sylphase/gpslog/notes.txt

solder paste stencil needs wider openings on NV08C-CSM to reach pad
remember to solder through-holes on USB connector
next revision should have a way to charge the battery via USB
