sylphase/gpslog/orders/newark1.pdf

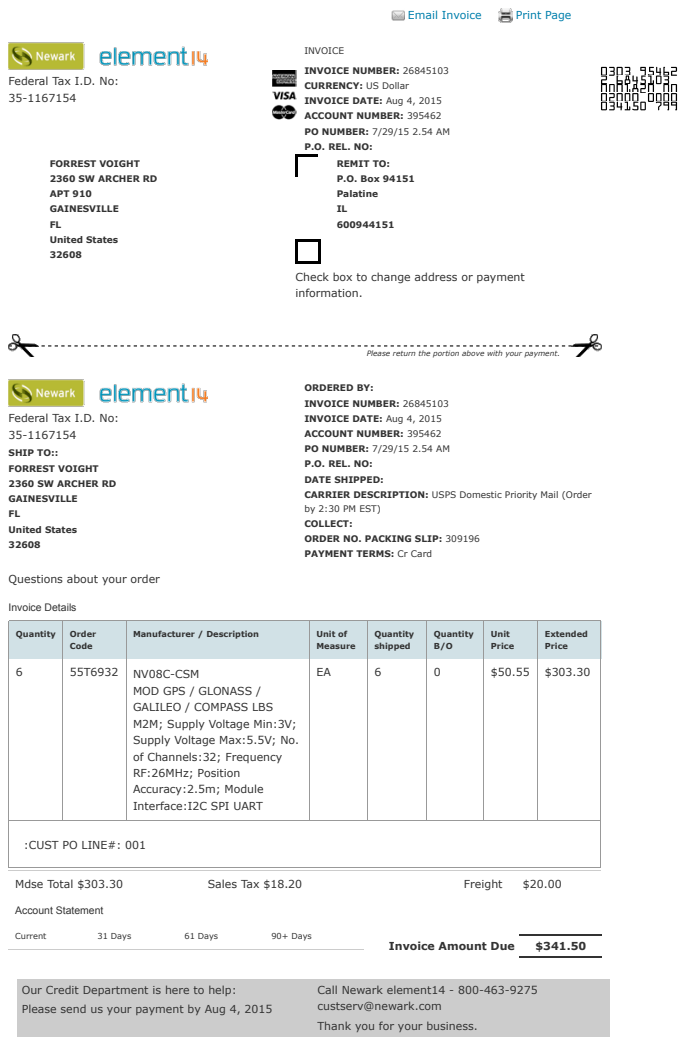
[picture p1: figure]
Email Invoice; Print Page; Federal Tax I.D. No: 35-1167154; INVOICE; INVOICE NUMBER: 26845103 CURRENCY: US Dollar INVOICE DATE: Aug 4, 2015 ACCOUNT NUMBER: 395462 PO NUMBER: 7/29/15 2.54 AM P.O. REL. NO:; FORREST VOIGHT 2360 SW ARCHER RD APT 910 GAINESVILLE FL United States 32608; SHIP TO:: FORREST VOIGHT 2360 SW ARCHER RD GAINESVILLE FL United States 32608; ORDERED BY: INVOICE NUMBER: 26845103 INVOICE DATE: Aug 4, 2015 ACCOUNT NUMBER: 395462 PO NUMBER: 7/29/15 2.54 AM P.O. REL. NO: DATE SHIPPED:; by 2:30 PM EST) COLLECT: ORDER NO. PACKING SLIP: 309196 PAYMENT TERMS: Cr Card; Current; 31 Days; 61 Days; 90+ Days; Invoice Amount Due; Our Credit Department is here to help:; Call Newark element14 - 800-463-9275 custserv@newark.com Thank you for your business.; Questions about your order; Invoice Details; Quantity; Order; Code; Manufacturer / Description; Unit of; Measure; Quantity shipped; Quantity B/O; Unit Price; Extended Price; NV08C-CSM; MOD GPS / GLONASS / GALILEO / COMPASS LBS M2M; Supply Voltage Min:3V; Supply Voltage Max:5.5V; No. of Channels:32; Frequency RF:26MHz; Position Accuracy:2.5m; Module Interface:I2C SPI UART; :CUST PO LINE#: 001; Mdse Total $303.30; Sales Tax $18.20; Freight; Account Statement; REMIT TO: P.O. Box 94151 Palatine IL 600944151; Check box to change address or payment information.

CARRIER DESCRIPTION: USPS Domestic Priority Mail (Order

Please send us your payment by Aug 4, 2015

Please return the portion above with your payment.

Newark element14 | https://www.newark.com/webapp/wcs/stores/servlet...
1 of 2 | 08/20/2015 07:26 PM

Newark element14 | https://www.newark.com/webapp/wcs/stores/servlet...
2 of 2 | 08/20/2015 07:26 PM
