sylphase/gpslog/orders/2a/oshpark1.pdf

Forrest Voight.
Home Shared Projects Design Rules Pricing & Specs Support Projects Order History Profile Cart Log out

# OSH Park

## Order Details

Order
number 5rKx9BIw

Order status Payment verification has been received from Stripe. Ordered on September 24th 2015.
Paid on September 24th 2015 via Stripe.

Items

gpslog_imu

0.38x0.42 inch (9.70x10.59 mm) 2 layer board. Your boards have been received from the fab and are awaiting depanelization and shipping.

12 boards at $0.75 per batch of three. | $3.00
OSH Park ~ Order Details | 10/06/2015 02:26 AM
https://oshpark.com/orders/5rKx9BIw | 1 of 2

Sub total | $3.00

gpslog_2a

1.45x1.12 inch (36.80x28.40 mm) 4 layer board. Your boards have been shipped. Track here.

3 boards at $16.10 per batch of three. | $16.10
Sub total | $16.10
USPS - Priority Mail | $5.00
TOTAL (paid) | $24.10

Shipping
Address

Forrest Voight
Sylphase
2360 SW Archer Rd
Apt 910
Gainesville
32608
Florida
United States

Designed and developed by Resistor.

OSH Park ~ Order Details | 10/06/2015 02:26 AM
https://oshpark.com/orders/5rKx9BIw | 2 of 2
