sylphase/gpslog/orders/navspark1.pdf

My Account | Sign out | Items / $0.00
NavSpark Store | Search
Home | My Account | Add New Address

# MY ACCOUNT

DEVELOPMENT BOARDS ADDITIONAL MODULES ACCESSORIES FREEBIE FORUM RESOURCES ABOUT CONTACT US TERMS

All prices are in USD

NavSpark Store - Order #1302 | https://store-lgdi92x.mybigcommerce.com/account.p...
1 of 3 | 08/20/2015 07:23 PM

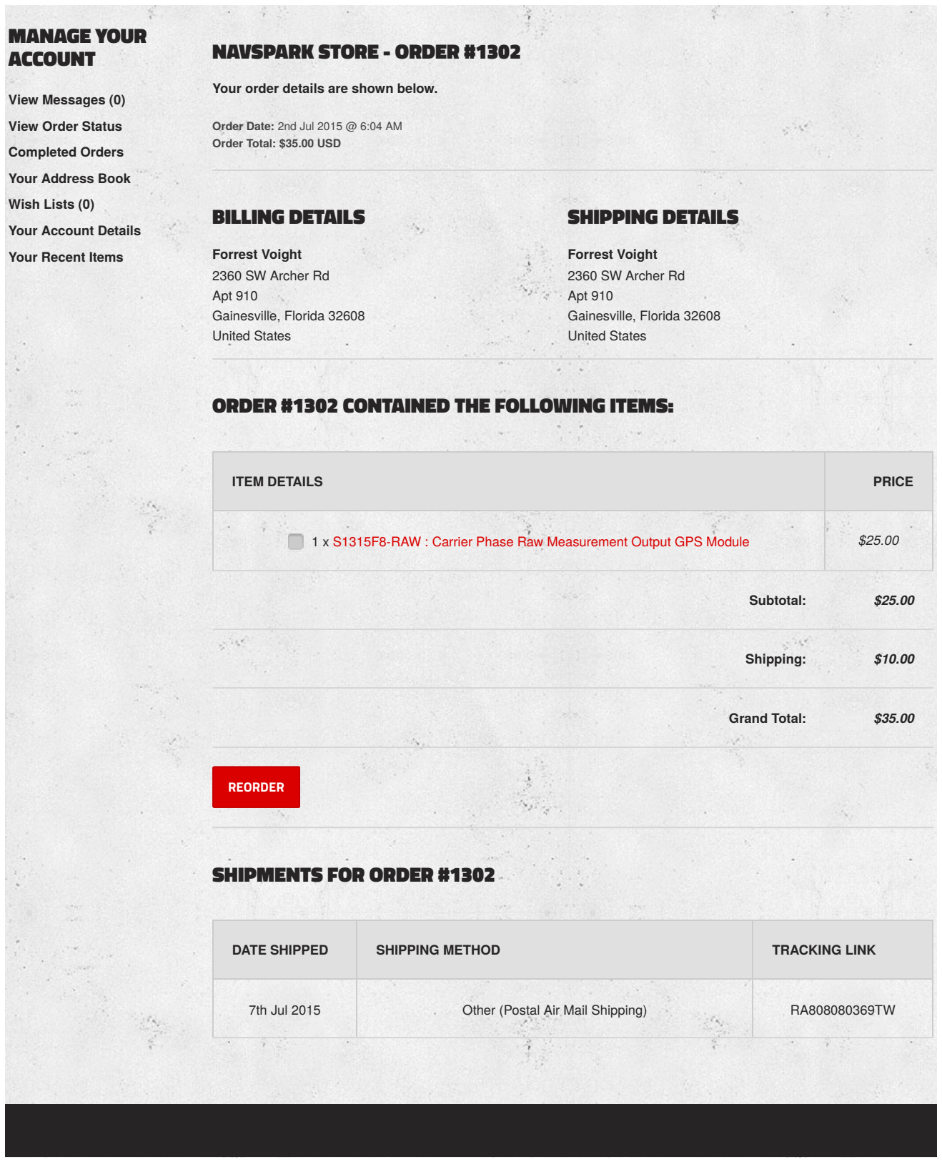
[picture p3: figure]
MANAGE YOUR ACCOUNT; View Messages (0) View Order Status Completed Orders Your Address Book Wish Lists (0) Your Account Details Your Recent Items; BILLING DETAILS; Forrest Voight 2360 SW Archer Rd Apt 910 Gainesville, Florida 32608 United States; SHIPPING DETAILS; NAVSPARK STORE - ORDER #1302; Your order details are shown below.; Order Date: 2nd Jul 2015 @ 6:04 AM Order Total: $35.00 USD; ITEM DETAILS; PRICE; REORDER; SHIPMENTS FOR ORDER #1302; DATE SHIPPED; SHIPPING METHOD; TRACKING LINK; 7th Jul 2015; Other (Postal Air Mail Shipping); Subtotal:; Shipping:; Grand Total:

## ORDER #1302 CONTAINED THE FOLLOWING ITEMS:

1 x S1315F8-RAW : Carrier Phase Raw Measurement Output GPS Module | $25.00

CATEGORIES

View all categories

CONNECT WITH US

All prices are in USD © 2015 NavSpark Store. Sitemap | Shopping Cart Software by Bigcommerce

Development Boards
Additional Modules
Accessories
Freebie
FORUM | RESOURCES | ABOUT | CONTACT US | TERMS
