sylphase/gpslog/orders/sager1.pdf

# INVOICE

### 19 Leona Drive

Middleborough, MA. 02346

SHIP TO: 84056

FORRE.ST
2360 SW ARCHER RD
APT 910
GAINESVILLE FL 32608

BILL TO: 84056

FORRE.ST
2360 SW ARCHER RD
APT 910
GAINESVILLE FL 32608
USA
INVOICE DATE | INVOICE NUMBER
07/29/15 | 0007012623

PLEASE REMIT PAYMENT TO:

Sager Electronics
PO Box 842544
Boston MA 02284-2544

CONTACT PHONE: 508-923-6628

PURCHASE ORDER | ORDERED BY | PAYMENT TERMS | SALESPERSON | ORDER NUMBER
S1213059 | Forrest Voight | Credit Card | Florida Web Orders | S002426416
SAGER PART NUMBER | CUSTOMER PART NUMBER | QUANTITY | UOM | UNIT PRICE | NET AMOUNT
0732511150

25

EA

1.9400

48.50

Shipping Point: MA PKID: 222015-S002426416-53 Tracking #: 1Z0114180332320673 Ship Via: UPS Ground No Payment Required - Prepaid by Credit Card | Subtotal | 48.50
| Shipping/Handling | 9.46
| 6.00 % Tax | 2.91
| AMOUNT DUE USD | 0.00

SAVE TIME. SAVE MONEY.
Receive your invoices faster by enrolling in our free e-billing invoicing service! Invoices are sent via email or fax. With email delivery you can download invoice data directly into your accounting system.
To sign up, contact your Sager A/R representative or email us at ar@sager.com.
