sylphase/gpslog/orders/2a/oshstencils1.pdf

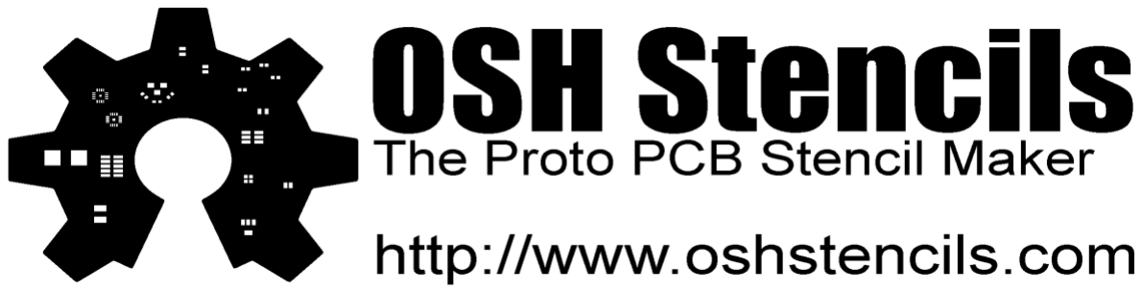
[picture p4: figure]

758 N 1890 W, Provo UT 84601 stencils@oshstencils.com

## Invoice: OS380d630-554

Ordered: 09-24-15
FORREST VOIGHT
SYLPHASE LLC
2360 SW ARCHER RD
APT 910
GAINESVILLE, FLORIDA 32608 UNITED STATES
Project Name | Dimensions | Price
Project 1 (TOP) | 2.845x2.88 | $5.33
Project 1 (BOTTOM) | 3.915x3.6 | $9.16
Project 1 (TOP) | 3.915x3.585 | $9.12
Subtotal: | $23.61
Shipping: | $5.25
Discounts: | -$4.72
Total: | $24.14

Powered by TCPDF (www.tcpdf.org)

1 / 1
