sylphase/gpslog/orders/2a/sparkfun1.pdf

## SparkFun Invoice

#2081162

6333 Dry Creek Parkway • Niwot, CO 80503 1-303-284-0979
Ordered: 2015-10-05 10:54:59 pm

Billing
Forrest Voight
2360 SW Archer Rd
Apt 910
Gainesville, Florida 32608 United States

Delivery
Forrest Voight
2360 SW Archer Rd
Apt 910
Gainesville, Florida 32608 United States
3059514199
forrest.voight@gmail.com

## Shipping Method: USPS First Class Mail

### Payment Method: Tokenized Credit Card Order Status: New Order

SKU | Product Name | Qty | Price | Total
BOB-11818 | SparkFun GPS Breakout | 2 | $3.95 | $7.90
GPS-00574 | JST SH Jumper 6 Wire - 1.75" | 2 | $2.95 | $5.90
GPS-09123 | JST SH Jumper 6 Wire - 1 Foot | 5 | $2.95 | $14.75
PRT-10361 | JST SH Jumper 6 Wire Assembly - 8" | 2 | $1.50 | $3.00

SUPPLIER'S CERTIFICATION OF COMPLIANCE
It is hereby certified that the product(s) provided in this shipment conform to the
requirements and the manufacturer's part number identified in the customer's purchase order and these parts have been received, stored and shipped by SparkFun Electronics.

### Casey DeLio, SparkFun Customer Service Manager

Subtotal | $31.55
Shipping/Handling | $4.13
Grand Total | $35.68

### Transactions:

### Oct-05 Credit Card

5821 | $35.68
Order Balance: | $0.00

These commodities, technology or software were exported from the United States in accordance with the Export Administration Regulations. Diversion contrary to U.S. law is prohibited.

Please direct any questions or concerns to cservice@sparkfun.com or (303) 284-0979.

Did you know SparkFun's packaging is recyclable?
Both our red boxes and brown paper packaging can be recycled in most areas. Thanks for doing your part!
