sylphase/gpslog/orders/1/digikey2.pdf

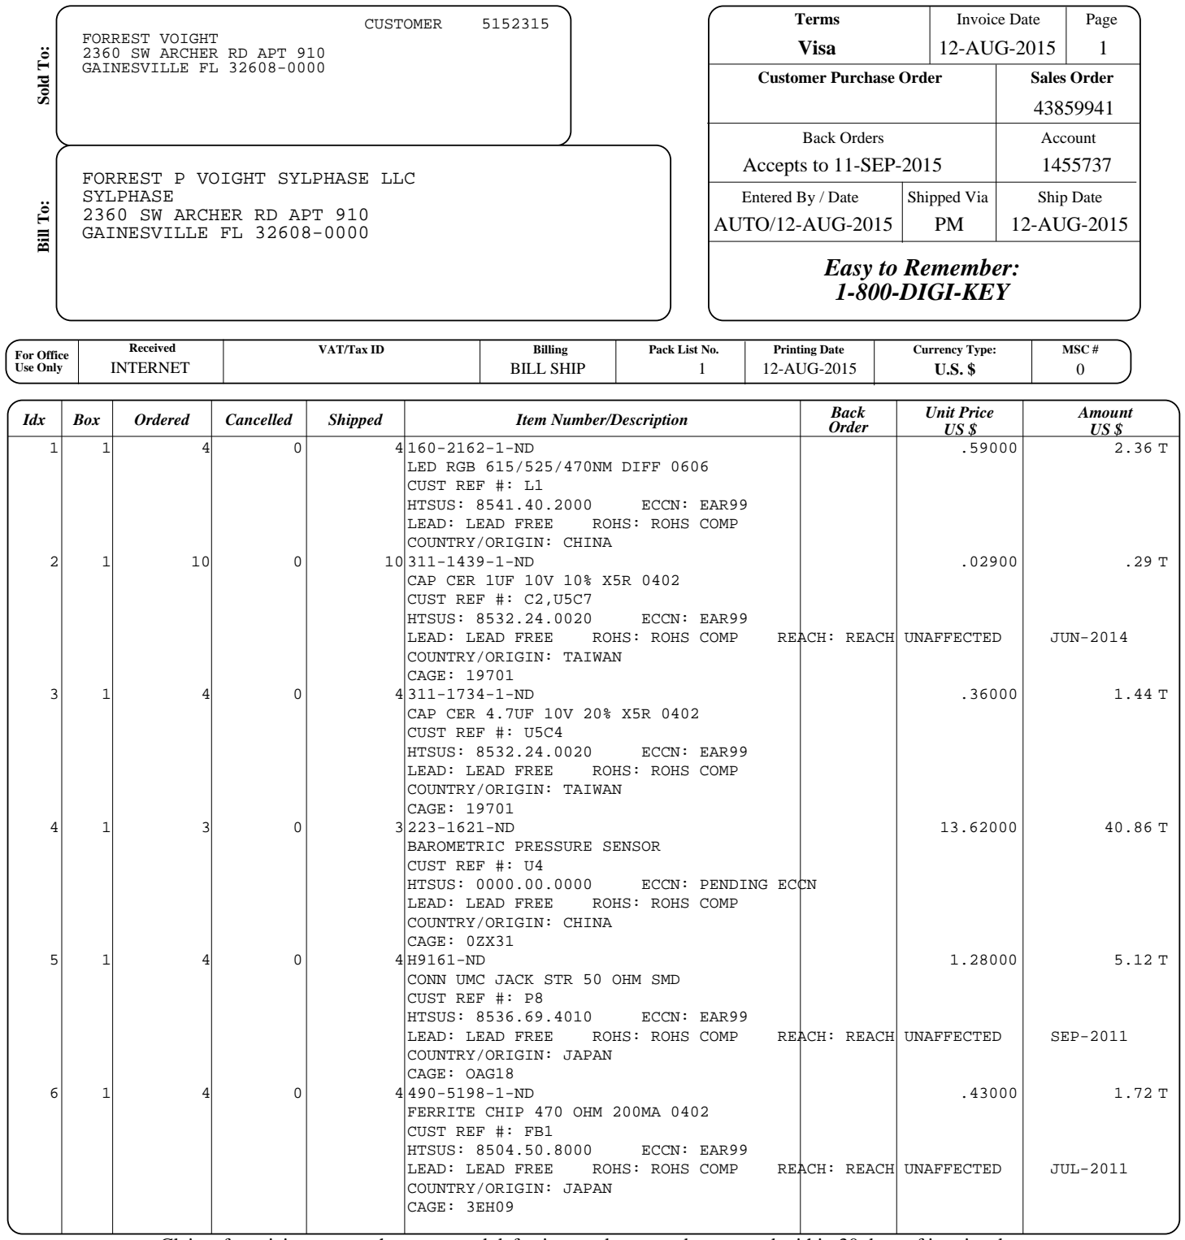
[picture p5: figure]
For Office Use Only; Received; Billing; Pack List No.; Sold To: Bill To:; Printing Date; Back Orders; Sales Order; Account; Customer Purchase Order; Invoice Date; Page; Entered By / Date; Shipped Via; Terms; Idx; Box; Ordered; Cancelled; Shipped; Item Number/Description; Back; Order; Unit Price; Amount; Currency Type:; MSC #; LED RGB 615/525/470NM DIFF 0606 CUST REF #: L1; HTSUS: 8541.40.2000; ECCN: EAR99; LEAD: LEAD FREE; ROHS: ROHS COMP; COUNTRY/ORIGIN: CHINA; CAP CER 1UF 10V 10% X5R 0402 CUST REF #: C2,U5C7; HTSUS: 8532.24.0020; REACH: REACH; UNAFFECTED; JUN-2014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

Claims for pricing errors, shortages, and defective product must be reported within 30 days of invoice date.

### www.digikey.com Orders 1-800-344-4539 Fax 218-681-3380

## Invoice # 50474566 U.S. $

701 Brooks Ave. South, Thief River Falls, MN 56701-0677 USA

## Contact Customer Service at 1-800-858-3616

## All transactions with Digi-Key, including its subsidiaries and/or affiliates, are subject to Digi-Key's Terms of Use and

Conditions of Order, available at www.digikey.com.

DUNS No: 05 760 2120 FEI No: 41-1234968 Any applicable sales tax not collected on this invoice is the responsibility of the customer.

Sold To:

Claims for pricing errors, shortages, and defective product must be reported within 30 days of invoice date.

Idx | Box | Ordered | Cancelled | Shipped | Item Number/Description | Back Order
Unit Price | Amount

Terms

Customer Purchase Order

Invoice Date | Page

Shipped Via

2

7 | 1 | 10 | 0 | 10 490-10435-1-ND | .02300 | .23 T
| | | | CAP CER 1UF 6.3V 20% X6S 0402
| | | | CUST REF #: REG_C1,REG_C2
HTSUS: 8532.24.0020 | ECCN: EAR99
LEAD: LEAD FREE | ROHS: ROHS COMP
| | | | COUNTRY/ORIGIN: JAPAN
8 | 1 | 4 | 0 | 4 101-00660-68-6-1-ND | 1.82000 | 7.28 T
| | | | CONN MICRO SD CARD PUSH-PUSH R/A
| | | | CUST REF #: P4
HTSUS: 8536.69.4040 | ECCN: EAR99
LEAD: LEAD FREE | ROHS: ROHS COMP
| | | | COUNTRY/ORIGIN: CHINA
| | | | CAGE: 74868
9 | 1 | 10 | 0 | 10 311-10MJRCT-ND | .01200 | .12 T
| | | | RES SMD 10M OHM 5% 1/16W 0402
| | | | CUST REF #: R1
HTSUS: 8533.21.0030 | ECCN: EAR99
LEAD: LEAD FREE | ROHS: ROHS COMP | REACH: REACH | UNAFFECTED | JUN-2014
| | | | COUNTRY/ORIGIN: TAIWAN
| | | | CAGE: 19701
10 | 1 | 4 | 0 | 4 490-6299-1-ND | .13000 | .52 T
| | | | CAP CER 0.12UF 10V 10% X5R 0402
| | | | CUST REF #: U3C3
HTSUS: 8532.24.0020 | ECCN: EAR99
LEAD: LEAD FREE | ROHS: ROHS COMP
| | | | COUNTRY/ORIGIN: JAPAN
| | | | CAGE: 3EH09
11 | 1 | 3 | 0 | 3 903-1015-ND | 1.90000 | 5.70 T
| | | | BOARD SHIELD 1.032X1.032" COVER
| | | | CUST REF #: SH_1
HTSUS: 8529.90.9900 | ECCN: EAR99
LEAD: LEAD FREE | ROHS: ROHS COMP | REACH: REACH | UNAFFECTED | AUG-2011
| | | | COUNTRY/ORIGIN: MEXICO
| | | | CAGE: U2585
12 | 1 | 25 | 0 | 25 311-1336-1-ND | .00720 | .18 T
| | | | CAP CER 0.1UF 10V 10% X5R 0402
| | | | CUST REF #: U3C1,U3C2,U4C,U5C0,U5C1,U5C2,U5C3,U6C1
HTSUS: 8532.24.0020 | ECCN: EAR99
LEAD: LEAD FREE | ROHS: ROHS COMP | REACH: REACH | UNAFFECTED | JUN-2014
| | | | COUNTRY/ORIGIN: TAIWAN
| | | | CAGE: 19701
13 | 1 | 10 | 0 | 10 311-51JRCT-ND | .01200 | .12 T
| | | | RES SMD 51 OHM 5% 1/16W 0402
| | | | CUST REF #: R8
HTSUS: 8533.21.0030 | ECCN: EAR99
LEAD: LEAD FREE | ROHS: ROHS COMP | REACH: REACH | UNAFFECTED | JUN-2014
| | | | COUNTRY/ORIGIN: TAIWAN
| | | | CAGE: 19701
14 | 1 | 4 | 0 | 4 609-4618-1-ND | .46000 | 1.84 T
| | | | CONN USB MICRO B RECPT SMT R/A
| | | | CUST REF #: P7
HTSUS: 8536.69.4040 | ECCN: EAR99
LEAD: LEAD FREE | ROHS: ROHS COMP | REACH: REACH | UNAFFECTED | DEC-2012
| | | | COUNTRY/ORIGIN: CHINA
| | | | CAGE: 22526

701 Brooks Ave. South, Thief River Falls, MN 56701-0677 USA

CUSTOMER 5152315
FORREST VOIGHT
2360 SW ARCHER RD APT 910
GAINESVILLE FL 32608-0000
Visa | 12-AUG-2015

PM

### Easy to Remember: 1-800-DIGI-KEY

US $ | US $

## Contact Customer Service at 1-800-858-3616

## All transactions with Digi-Key, including its

Sold To:

Claims for pricing errors, shortages, and defective product must be reported within 30 days of invoice date.

Idx | Box | Ordered | Cancelled | Shipped | Item Number/Description | Back Order
Unit Price | Amount

Terms

Customer Purchase Order

Invoice Date | Page

Shipped Via

3

15 | 1 | 3 | 0 | 3 903-1052-1-ND | 2.32000 | 6.96 T
| | | | BOARD SHIELD 1.032X1.032" FRAME
| | | | CUST REF #: SH_0
HTSUS: 8529.90.9900 | ECCN: EAR99
LEAD: LEAD FREE | ROHS: ROHS COMP | REACH: REACH | UNAFFECTED | AUG-2011
| | | | COUNTRY/ORIGIN: MEXICO
| | | | CAGE: U2585
16 | 1 | 4 | 0 | 4 455-1749-1-ND | .56000 | 2.24 T
| | | | CONN HEADER PH SIDE 2POS 2MM SMD
| | | | CUST REF #: P3
HTSUS: 8536.69.4040 | ECCN: EAR99
LEAD: LEAD FREE | ROHS: ROHS COMP | REACH: REACH | NOT APPLICABLE
| | | | COUNTRY/ORIGIN: MALAYSIA
| | | | CAGE: 67D17
17 | 1 | 10 | 0 | 10 490-1312-1-ND | .01200 | .12 T
| | | | CAP CER 10000PF 25V 10% X7R 0402
| | | | CUST REF #: U5C6
HTSUS: 8532.24.0020 | ECCN: EAR99
LEAD: LEAD FREE | ROHS: ROHS COMP | REACH: REACH | UNAFFECTED | JUL-2011
| | | | COUNTRY/ORIGIN: CHINA
| | | | CAGE: 3EH09
18 | 1 | 10 | 0 | 10 311-1.5KJRCT-ND | .01200 | .12 T
| | | | RES SMD 1.5K OHM 5% 1/16W 0402
| | | | CUST REF #: R6
HTSUS: 8533.21.0030 | ECCN: EAR99
LEAD: LEAD FREE | ROHS: ROHS COMP | REACH: REACH | UNAFFECTED | JUN-2014
| | | | COUNTRY/ORIGIN: TAIWAN
| | | | CAGE: 19701
19 | 1 | 10 | 0 | 10 A106045CT-ND | .01000 | .10
| | | | RES SMD 10K OHM 5% 1/16W 0402
| | | | CUST REF #: R5,R7,U3R1
HTSUS: 8533.21.0030 | ECCN: EAR99
LEAD: LEAD FREE | ROHS: ROHS COMP
| | | | COUNTRY/ORIGIN: THAILAND
| | | | CAGE: 00779
20 | 1 | 4 | 0 | 4 SSM3K15AFSLFCT-ND | .20000 | .80 T
| | | | MOSFET N-CH 30V 0.1A SSM
| | | | CUST REF #: Q1
HTSUS: 8541.21.0095 | ECCN: EAR99
LEAD: LEAD FREE | ROHS: ROHS COMP
| | | | COUNTRY/ORIGIN: CHINA
| | | | CAGE: 0JR04
21 | 1 | 10 | 0 | 10 311-1719-1-ND | .01300 | .13 T
| | | | CAP CER 6800PF 25V 10% X7R 0402
| | | | CUST REF #: U3C4
HTSUS: 8532.24.0020 | ECCN: EAR99
LEAD: LEAD FREE | ROHS: ROHS COMP
| | | | COUNTRY/ORIGIN: TAIWAN
| | | | CAGE: 19701
22 | 1 | 4 | 0 | 4 336-2872-ND | .99000 | 3.96 T
| | | | OSC CMEMS 8.000MHZ LVCMOS SMD
| | | | CUST REF #: U6
HTSUS: 8541.60.0080 | ECCN: EAR99
LEAD: LEAD FREE | ROHS: ROHS COMP
| | | | COUNTRY/ORIGIN: SOUTH KOREA

701 Brooks Ave. South, Thief River Falls, MN 56701-0677 USA

CUSTOMER 5152315
FORREST VOIGHT
2360 SW ARCHER RD APT 910
GAINESVILLE FL 32608-0000
Visa | 12-AUG-2015

PM

### Easy to Remember: 1-800-DIGI-KEY

US $ | US $

## Contact Customer Service at 1-800-858-3616

## All transactions with Digi-Key, including its

Sold To:

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

Idx | Box | Ordered | Cancelled | Shipped | Item Number/Description | Back Order
Unit Price | Amount

Terms

Customer Purchase Order

Invoice Date | Page

Shipped Via

4

23 | 1 | 4 | 0 | 4 CUS520H3FCT-ND | .21000 | .84 T
| | | | DIODE SCHOTTKY 30V 200MA
| | | | CUST REF #: D1
HTSUS: 8541.10.0080 | ECCN: EAR99
LEAD: LEAD FREE | ROHS: ROHS COMP
| | | | COUNTRY/ORIGIN: THAILAND
24 | 1 | 3 | 0 | 3 497-11518-ND | 7.76000 | 23.28 T
| | | | MCU ARM 32BIT 64K FLASH 48LQFP
| | | | CUST REF #: U5
HTSUS: 8542.31.0000 | ECCN: 3A991A2
LEAD: LEAD FREE | ROHS: ROHS COMP | REACH: REACH | UNAFFECTED | JUL-2011
| | | | COUNTRY/ORIGIN: CHINA
| | | | CAGE: 50088
25 | 1 | 10 | 0 | 10 311-5.6KJRCT-ND | .01200 | .12 T
| | | | RES SMD 5.6K OHM 5% 1/16W 0402
| | | | CUST REF #: R3,R4
HTSUS: 8533.21.0030 | ECCN: EAR99
LEAD: LEAD FREE | ROHS: ROHS COMP | REACH: REACH | UNAFFECTED | JUN-2014
| | | | COUNTRY/ORIGIN: TAIWAN
| | | | CAGE: 19701
26 | 1 | 10 | 0 | 10 311-1018-1-ND | .01200 | .12 T
| | | | CAP CER 22PF 50V 5% NPO 0402
| | | | CUST REF #: C1
HTSUS: 8532.24.0020 | ECCN: EAR99
LEAD: LEAD FREE | ROHS: ROHS COMP | REACH: REACH | UNAFFECTED | JUN-2014
| | | | COUNTRY/ORIGIN: TAIWAN
| | | | CAGE: 19701
27 | 1 | 3 | 3 | 863-1491-1-ND | .17000 | .00
| | | | IC REG LDO 3.3V 0.15A SOT23-5
| | | | CUST REF #: REG_U1
PART OBSOLETE
HTSUS: 8542.39.0000 | ECCN: EAR99
LEAD: LEAD FREE | ROHS: ROHS COMP
| | | | CAGE: 17540
BOX | 1 SHIPPED PM | WEIGHT | 1 LBS 0 OZS (0.45 KG)
| | | | BOX ID 9205590106460315089063
| | | | TOTAL INVOICED | | 106.57
| | | | SHIPPING CHARGES APPLIED | | 7.35
| | | | ** CHARGES SUBTOTAL ** | | 113.92
| | | | SALES TAX | | 6.40
| | | | (T INDICATES TAXABLE AMOUNTS)
| | | | TOTAL CHARGED TO CREDIT CARD | | 120.32
| | | | | | U.S. $$

YOUR CREDIT CARD HAS BEEN CHARGED THE ABOVE INDICATED AMOUNT
| | | | THE ORDER IS COMPLETE
| | | | REF #: SA # 43859941

701 Brooks Ave. South, Thief River Falls, MN 56701-0677 USA

CUSTOMER 5152315
FORREST VOIGHT
2360 SW ARCHER RD APT 910
GAINESVILLE FL 32608-0000
Visa | 12-AUG-2015

PM

### Easy to Remember: 1-800-DIGI-KEY

US $ | US $

## Contact Customer Service at 1-800-858-3616

## All transactions with Digi-Key, including its

Sold To:

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

Idx | Box | Ordered | Cancelled | Shipped | Item Number/Description | Back Order
Unit Price | Amount

Terms

Customer Purchase Order

Invoice Date | Page

Shipped Via

5

Ship To: FORREST VOIGHT
SYLPHASE
2360 SW ARCHER RD APT 910
GAINESVILLE FL 32608-0000

Ship From: DIGI-KEY
701 BROOKS AVE. SOUTH
P.O. BOX 677
THIEF RIVER FALLS MN 56701-0677

General - WEB ORDER ID: 149177679
12-AUG-2015 DUE TO INVENTORY DISCREPANCY | 3 PCS OF | 863-1491-1-ND | HAVE BEEN
CANCELLED. OBSOLETE PARTS CANNOT BE PLACED ON B/O. | A57V/3978
8/12/15 REC'D CALL FROM A57V W/ ABOVE DISCREPANCY. | ELECTED TO SHIP AS IS.
NOTIFIED CUST. A4ZG/2436
*NOTE: ONE OR MORE ITEMS ON THIS ORDER ARE CONTROLLED FOR EXPORT.

701 Brooks Ave. South, Thief River Falls, MN 56701-0677 USA

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

PM

### Easy to Remember: 1-800-DIGI-KEY

US $ | US $

## Contact Customer Service at 1-800-858-3616

## All transactions with Digi-Key, including its

DUNS No: 05 760 2120 FEI No: 41-1234968 Any applicable sales tax not collected on this invoice is the responsibility of the customer. These commodities, technology or software were exported from the United States in accordance with the Export Administration regulations. Diversion contrary to U.S. law prohibited.
CERTIFICATE OF COMPLIANCE: | The Digi-Key components included in the above shipment are genuine components and were provided by the applicable manufacturer to Digi-Key. Test reports (chemical, physical, electrical, etc., together with results of any tests performed by the manufacturer) are on file (either here or in the plant of the manufacturer) and will be made available upon request. These components have been handled in accordance with the requirements of applicable quality standards. This certification is valid only to the original customer and is not transferable. Contact Customer Service at 800-858-3616 if you have any questions.
| Kim Gilbert, Director, Customer Service
