sylphase/gpslog/orders/1/oshpark1.pdf

Forrest Voight.
Home Shared Projects Design Rules Pricing & Specs Support Projects Order History Profile Cart Log out

# OSH Park

## Receipt for Order #qZKGmQ1z

Shipped to: | Order details:
Forrest Voight
Sylphase
2360 SW Archer Rd
Apt 910 Gainesville Florida
32608 United States | Order ID: qZKGmQ1z User: Forrest Voight (forrest.voight@gmail.com) Ordered at: July 12th 2015 Payment received at: July 12th 2015 Payment method: Paypal Payment ID: 1LP96588G2664340J Shipping method: USPS - Priority Mail

Item Quantity Price
gpslog 3 | $35.00
Subtotal | $35.00
Shipping | $5.00
Total | $40.00

Paid in full

OSH Park, LLC
543 3rd St, Suite C12
Lake Oswego, OR 97034

Designed and developed by Resistor.

OSH Park ~ Receipt for Order #qZKGmQ1z | https://oshpark.com/orders/qZKGmQ1z/receipt
1 of 1 | 08/20/2015 07:16 PM
