sylphase/gpslog/orders/1/oshpark2.pdf

Forrest Voight.
Home Shared Projects Design Rules Pricing & Specs Support Projects Order History Profile Cart Log out

# OSH Park

## Receipt for Order #NZZoKplM

Shipped to: | Order details:
Forrest Voight
Sylphase
2360 SW Archer Rd
Apt 910 Gainesville Florida
32608 United States | Order ID: NZZoKplM User: Forrest Voight (forrest.voight@gmail.com) Ordered at: August 21st 2015 Payment received at: August 21st 2015 Payment method: Stripe Payment ID: ch_6pvgILT931K2eJ Shipping method: USPS - Priority Mail

Item Quantity Price
gpslog3 6 | $35.00
Subtotal | $70.00
Shipping | $5.00
Total | $75.00

Paid in full

OSH Park, LLC
543 3rd St, Suite C12
Lake Oswego, OR 97034

Designed and developed by Resistor.

OSH Park ~ Receipt for Order #NZZoKplM | https://oshpark.com/orders/NZZoKplM/receipt
1 of 1 | 08/21/2015 09:45 AM
