sylphase/gpslog/orders/1/oshstencils1.pdf

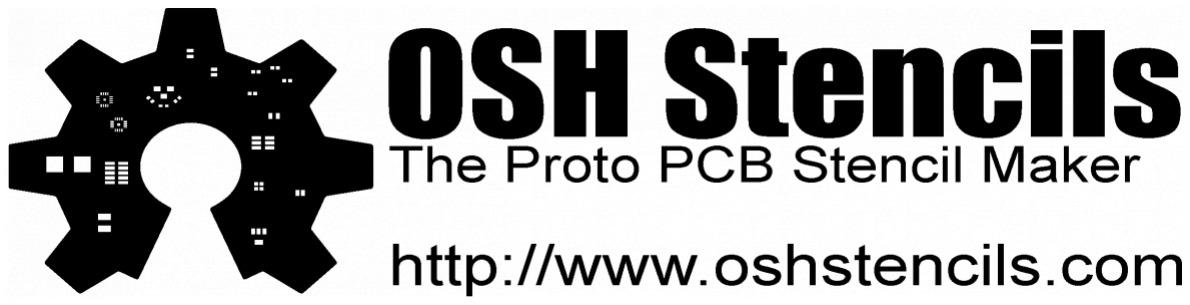
[picture p6: figure]

5219 N Morning Dove Circle, Lehi UT 84043 stencils@oshstencils.com

## Invoice: OS4458d37-554

Ordered: 07-28-15
FORREST VOIGHT
SYLPHASE LLC
2360 SW ARCHER RD
APT 910
GAINESVILLE, FLORIDA 32608 UNITED STATES
Project Name | Dimensions | Price
Project 1 (TOP) | 5.365x3.655 | $12.75
Subtotal: | $12.75
Shipping: | $5.25
Discounts: | -$2.58
Total: | $15.42

Powered by TCPDF (www.tcpdf.org)

1 / 1
