sylphase/gpslog/orders/1/sparkfun1.pdf

## SparkFun Invoice

#1219744

6333 Dry Creek Parkway • Niwot, CO 80503 1-303-284-0979
Ordered: 2015-04-27 07:15:03 pm

Billing
Forrest Voight
2360 SW Archer Rd
Apt 910
Gainesville, Florida 32608 United States

Delivery
Forrest Voight
2360 SW Archer Rd
Apt 910
Gainesville, Florida 32608 United States
3059514199
forrest.voight@gmail.com

## Shipping Method: USPS First Class Mail

Tracking Number: 9400115901467198682829
Payment Method: Credit Card
Order Status: Shipped 2015-04-28
SKU | Product Name | Qty | Price | Total
PRT-09015 | Header - 6-pin Male (SMD, 0.1", Right Angle)
40 | $0.86 | You save:
$3.60 (9%)
| | | | $34.40

SUPPLIER'S CERTIFICATION OF COMPLIANCE
It is hereby certified that the product(s) provided in this shipment conform to the requirements and the manufacturer's part number identified in the customer's purchase order and these parts have been received, stored and shipped by SparkFun Electronics.

Casey DeLio, SparkFun Customer Service Manager

Subtotal | $34.40
Shipping/Handling | $4.01
Grand Total | $38.41
Transactions:
Apr-27 Credit Card
5821 | $38.41
Order Balance: | $0.00

These commodities, technology or software were exported from the United States in accordance with the Export Administration Regulations. Diversion contrary to U.S. law is prohibited.

Please direct any questions or concerns to cservice@sparkfun.com or (303) 284-0979.

Did you know SparkFun's packaging is recyclable?
Both our red boxes and brown paper packaging can be recycled in most areas. Thanks for doing your part!
