sylphase/gpslog/imu_pcb/kicad/pcb.kicad_pcb

## KiCad design imu_pcb/kicad/pcb.kicad_pcb (2015-10-01)

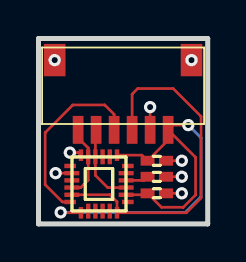
[picture p11: board imu_pcb/kicad/pcb.kicad_pcb from above]

Board: 2 copper layers, 9.4 x 10.3 mm, 5 parts (0 on the bottom side), 7 nets.

Parts:
P9: SM06B-SRSS-TB; 01922d69cd78564e6dcfb13f8efada47fcd2f6e470f341a81a2c1d54604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
U3: MPU-9250; f9dcab91837b679375d9ef0965a978d518e3e45905c50e49de42089f4da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
U3C1, U3C2: CC0402KRX5R6BB104; da492ed0915bf61186c52e71902aed48c4ab3f939acb966f1f6c31e1d73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
U3C3: GRM155R71E103KA01D; da492ed0915bf61186c52e71902aed48c4ab3f939acb966f1f6c31e1d73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

Connections:
REGOUT: U3.10, U3C1.1
gnd: P9.2, P9.M, U3.18, U3.20, U3C1.2, U3C2.2, U3C3.2
imu_spi_nCS: P9.6, U3.17, U3.22
sensor_spi_MISO: P9.5, U3.9, U3.16
sensor_spi_MOSI: P9.4, U3.24
sensor_spi_SCLK: P9.3, U3.6, U3.23
vcc3_3: P9.1, U3.1, U3.8, U3.13, U3C2.1, U3C3.1
