sylphase/gpslog/firmware/src/main.cpp

#include <cstdio>
#include <math.h>
#include <unistd.h>
#include <cstring>

#include <libopencm3/stm32/rcc.h>
#include <libopencm3/stm32/gpio.h>
#include <libopencm3/stm32/usart.h>
#include <libopencm3/cm3/cortex.h>

#include "main.h"

#include "hardware.h"
#include "time.h"
#include "serial.h"
#include "gps.h"
#include "sdcard.h"
#include "coroutine.h"
#include "sensors.h"
#include "reactor.h"
#include "misc.h"
#include "scheduler.h"

static void clock_setup(void) {
    rcc_clock_setup_in_hse_8mhz_out_72mhz();
    
    rcc_periph_reset_pulse(RST_GPIOA); rcc_periph_clock_enable(RCC_GPIOA);
    rcc_periph_reset_pulse(RST_GPIOB); rcc_periph_clock_enable(RCC_GPIOB);
    rcc_periph_reset_pulse(RST_GPIOC); rcc_periph_clock_enable(RCC_GPIOC);
    rcc_periph_reset_pulse(RST_AFIO); rcc_periph_clock_enable(RCC_AFIO);
}

extern "C" {

void _exit(int status) {
    // called on assertion failure - blink red/green to indicate
    // assert's print won't do anything weird since it uses stderr and, as a result, blocking usart calls
    // nothing here should depend on interrupts ... since we might have been servicing an interrupt
    cm_disable_interrupts();
    set_led_override_off(false);
    while(true) {
        set_led_color(10, 0, 0);
        busy_delay(.25); // time stuff normally uses interrupts, but will work (possibly losing time elsewhere) if interrupts aren't working
        set_led_color(0, 10, 0);
        busy_delay(.25);
        
        float vdd = measure_vdd();
        if(hardware_get_battery_really_dead(vdd)) {
            set_led_color(10, 0, 0);
            busy_delay(0.001);
            poweroff();
        }
    }
}

void * __dso_handle = nullptr;

}


static volatile bool got_filename = false;
static char filename[128] = {0};
void got_date_string(char const *str) {
    strncpy(filename, str, sizeof(filename));
    got_filename = true;
}

static Coroutine<2048> main_coroutine;
    
auto main_function = []() {
    time_init();
    hardware_init();
    
    set_led_color(10, 0, 0); // draws current, decreasing the battery voltage slightly, purposely done before measuring
    
    serial_setup();
    scheduler_init();
    
    busy_delay(0.0001); // wait for battery voltage to dip
    {
        float vdd = measure_vdd();
        my_printf("vdd: %f\n", vdd);
        if(hardware_get_battery_dead(vdd)) {
            poweroff();
        }
    }
    
    sdcard_init();
    
    my_printf("sdcard mounted, starting gps\n");
    
    gps_setup();
    
    my_printf("init done, hello world!\n");
    my_printf("waiting for date from gps...\n");
    set_led_color(0, 0, 1); // blue
    
    while(!got_filename) yield_delay(0.1);
    my_printf("got date filename: %s! opening\n", filename);
    sdcard_open(filename);
    
    #ifdef SYLPHASE_GPSLOG_2A
        sensors_init();
    #endif
    
    sdcard_poll();
    sdcard_poll();
    gps_start_logging();
    
    #ifdef SYLPHASE_GPSLOG_2A
        set_external_led(true);
        uint64_t led_off_time = time_get_ticks() + 1 * time_get_ticks_per_second();
    #endif
    
    set_led_color(0, 1, 0);
    
    while(true) {
        sdcard_poll();
        
        #ifdef SYLPHASE_GPSLOG_2A
            if(time_get_ticks() >= led_off_time) {
                set_external_led(false);
            }
        #endif
        
        float vdd = measure_vdd();
        if(hardware_get_battery_really_dead(vdd)) {
            set_led_color(10, 0, 0);
            busy_delay(0.001);
            poweroff();
        }
        
        yield_delay(0.01); // XXX determines maximum write speed to card!
    }
};

int main(void) {
    clock_setup();
    main_coroutine.start(main_function);
    reactor_run();
}
