sylphase/gpslog/firmware/src/noncopyable.h

#ifndef GUARD_VXUYDNJHMDZRKYKS
#define GUARD_VXUYDNJHMDZRKYKS

class noncopyable {
protected:
    constexpr noncopyable() = default;
    ~noncopyable() = default;
    noncopyable(noncopyable const &) = delete;
    noncopyable & operator=(noncopyable const &) = delete;
};

#endif
