sylphase/gpslog/(commit log)

2015-07-09 netlist and placement done
    [pcb.kicad_pcb]
2015-07-10 added stm decoupling according to datasheet
    [pcb.kicad_pcb]
2015-07-12 added diode to supply power via uart port
    [pcb.kicad_pcb]
2015-08-06 ordering parts, some minor problems seen during assembly
    [pcb.kicad_pcb]
2015-08-10 driving RGB LED with timer
2015-08-11 fixed flash of wrong color on startup
    [hardware.cpp]
2015-08-12 sped up LED PWM
2015-08-13 attribute interrupt no longer necessary
    [gps.cpp, serial.cpp, time.cpp]
2015-08-15 found root problem (RAM too full, malloc was overwriting stack)
    [coroutine.h, gps.cpp, main.cpp, reactor.cpp]
2015-08-17 ahrs i2c seemingly working
2015-08-18 printing ahrs output
    [pcb.kicad_pcb]
2015-08-19 fixed painful scheduler bug
    [coroutine.h, scheduler.cpp]
2015-08-19 converted serial interrupt to use runner instead of coroutine pointer
2015-08-19 turn off LED when sleeping as an activity indicator
2015-08-22 doc, orders, etc
    [pcb.kicad_pcb]
2015-08-23 stay red until actually waiting for gps data, so sdcard init failure is clear
    [hardware.cpp, main.cpp]
2015-08-23 fixup! turn off LED when sleeping as an activity indicator
    [main.cpp]
2015-10-05 placement done
    [pcb.kicad_pcb]
2015-10-05 mostly routed
    [pcb.kicad_pcb]
2015-10-05 2c: completely routed
    [pcb.kicad_pcb]
2015-10-06 2c done
    [pcb.kicad_pcb]
2015-10-17 baro -> sensors
2015-10-17 partial multiple imu support
2015-10-21 record IMUs
2015-11-23 2A sync LED
2016-01-09 turn led yellow if buffer overrun
2016-01-12 read from magnetometer
